LaskaKit/ESP32-H2-DEVKit/Version.md

### Version 2.0
- Redo all power part, now stable power
- Battery ADC pin changed from IO2 to IO3
- LED pin changed from IO9 to IO22
#### Version 1.1
- Initial | Počáteční
