LaskaKit/ESP32-H2-DEVKit/README_CZ.md

ESP32-H2 DevKit

# ESP32-H2 DEVkit

Vývojová deska s mikrokontrolerem ESP32-H2 speciálně navržená pro ultra nízkopříkonové IoT aplikace napájené z baterií. ESP32-H2-DEVKit je vývojová deska založená na ESP32-H2-MINI-1-N4, modulu pro všeobecné použití s 4MB SPI flash. Tato deska integruje kompletní funkce Bluetooth, ZigBee, Threada  Matter. Pozor! nemá Wi-Fi! Díky své volbě použitých komponent a obvodovému řešení se jedná o jednu z desek s extrémně malou spotřebou v režimu spánku. Také použitý typ mikrokontroleru - SoC ESP32 předurčuje tuto desku do vysoce výkonných IoT aplikací. Deska obsahuje i integrovanou nabíječku jednoho Li-ION článku, ze kterého je pak deska i napájena. S touto deskou již nemusíte volit mezi výkonem a spotřebou a tak se můžete plně soustředit na vlastní vývoj aplikace skoro bez omezení.

Rozteč I/O pinů byla záměrně zvolena tak, aby bylo možné celou desku ve fázi vývoje zasunout do nepájivého kontaktního pole, což může značně zjednodušit prvotní návrh vyvíjené aplikace.

Deska již obsahuje integrovaný programátor a tak již není nutné žádný jiný používat. Díky novému čipu programátoru a jeho zapojení není zásadně ovlivně spotřeba v režimu spánku a tudíž jej lze využívat i pro aplikace náročné na dlouhou dobu provozu při napájení z baterie.

Pro rychlý start s ESP32-H2 DevKit jsme připravili několik vzorových kódu https://github.com/LaskaKit/ESP32-H2-DEVKit/tree/main/SW

I2C (uŠup):</br>
SDA - IO11</br>
SCL - IO10</br>
Napájení - IO12</br>
</br>
Měření napětí baterie:</br>
IO2</br>
</br>
RGB LED:</br>
Data - IO9</br>
</br>
SPI (uŠup):</br>
CS - IO1</br>
SDI/MOSI - IO5</br>
MISO - IO0</br>
CLK - IO4</br>
</br>
## Vývojový kit ESP32-H2 DevKit můžeš zakoupit u nás na https://www.laskakit.cz/laskakit-esp32-h2-devkit-bluetooth--zigbee--thread--matter/
