LaskaKit/ESP32-H2-DEVKit/img/laskakit-esp32-h2-devkit-bluetooth--zigbee--thread--matter-3.jpg

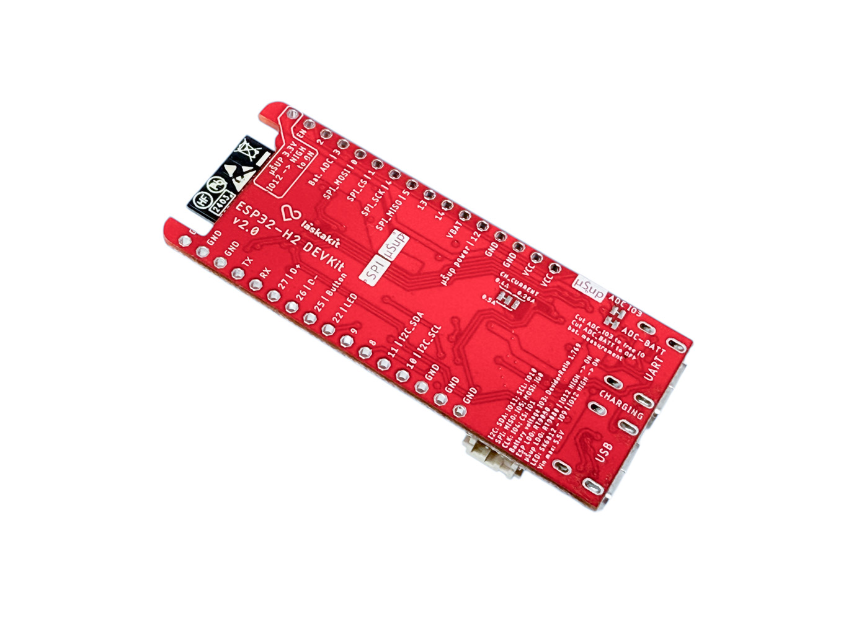
img/laskakit-esp32-h2-devkit-bluetooth--zigbee--thread--matter-3.jpg
