LaskaKit/ESP32-H2-DEVKit/HW/ESP32-H2-DEVKit_v2.pdf

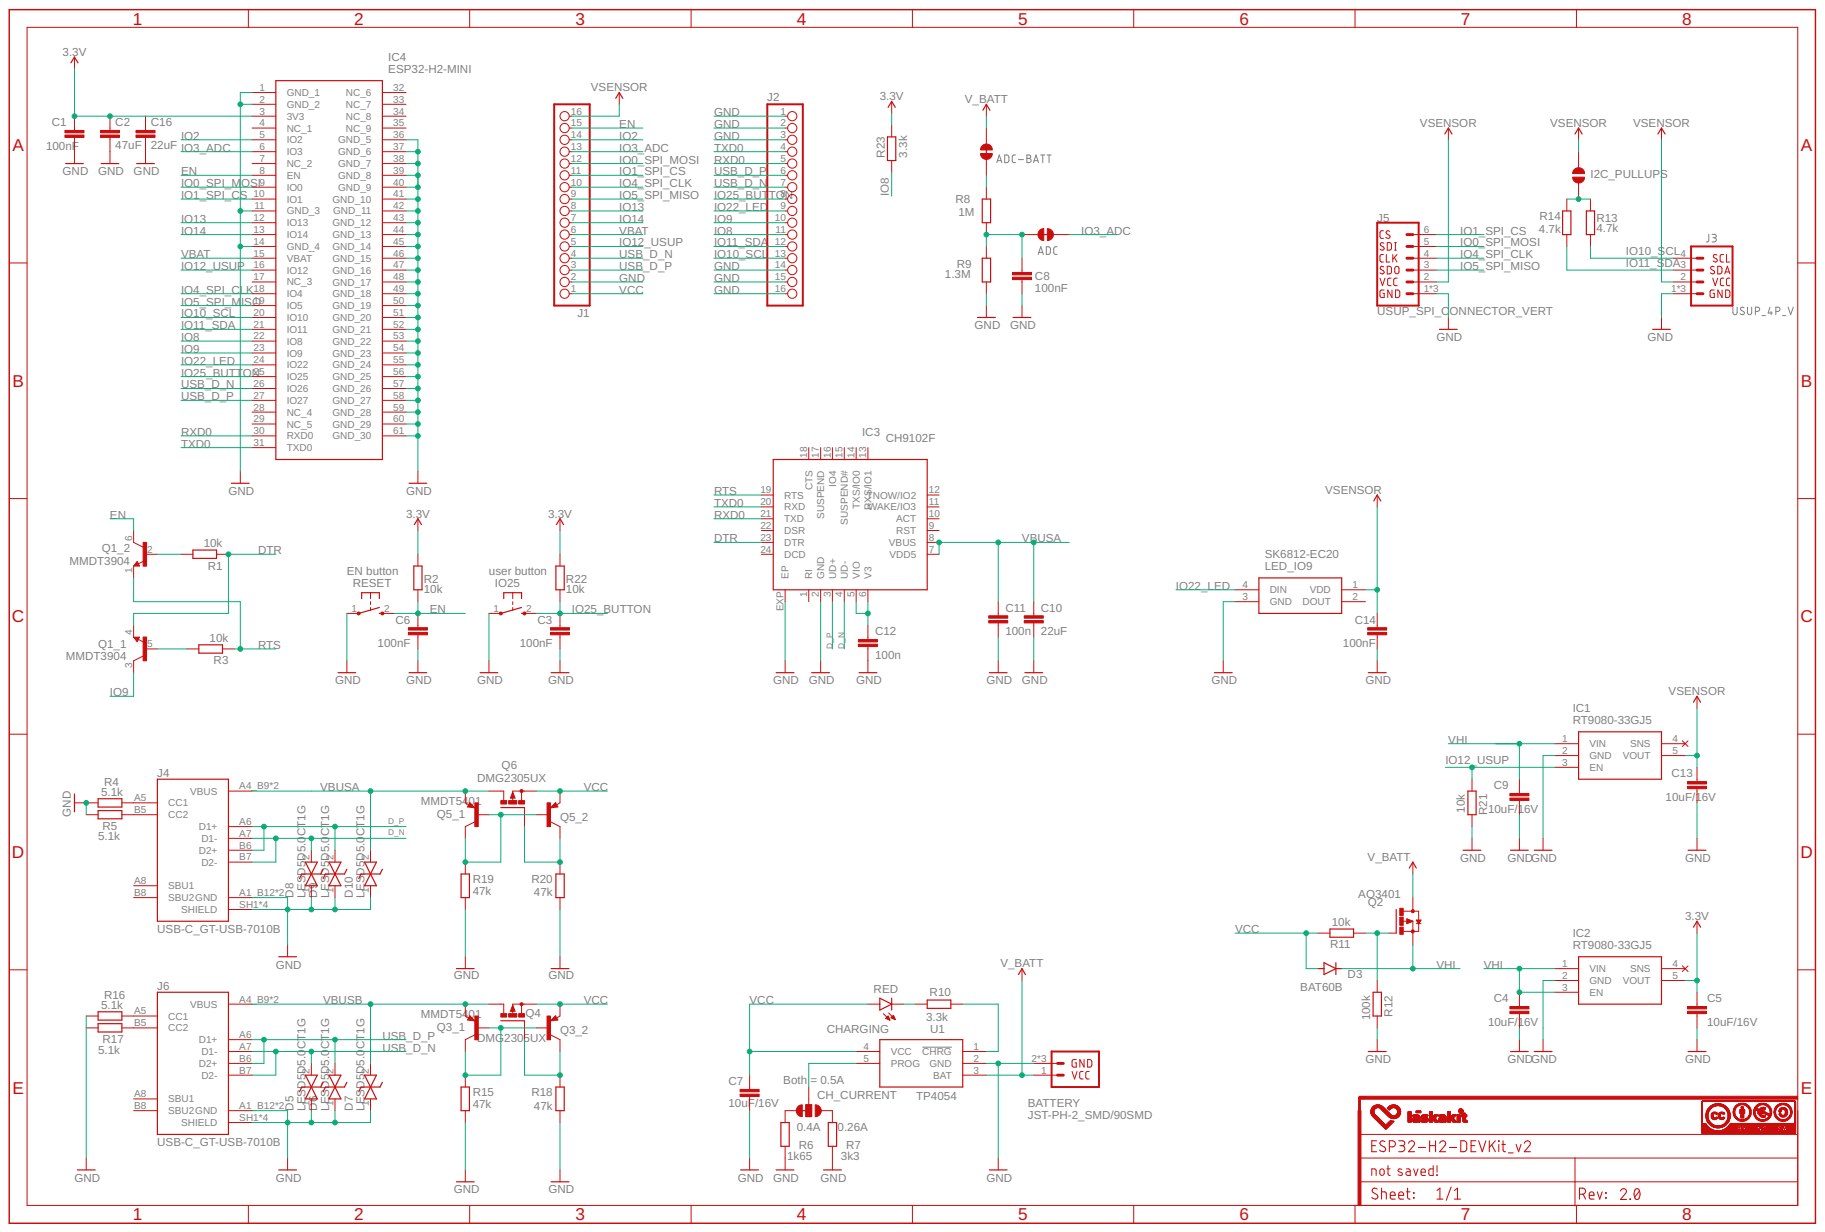
[picture p5: page 1]
