LaskaKit/ESP32-H2-DEVKit/HW/ESP32-H2-DEVKit_v1_1.pdf

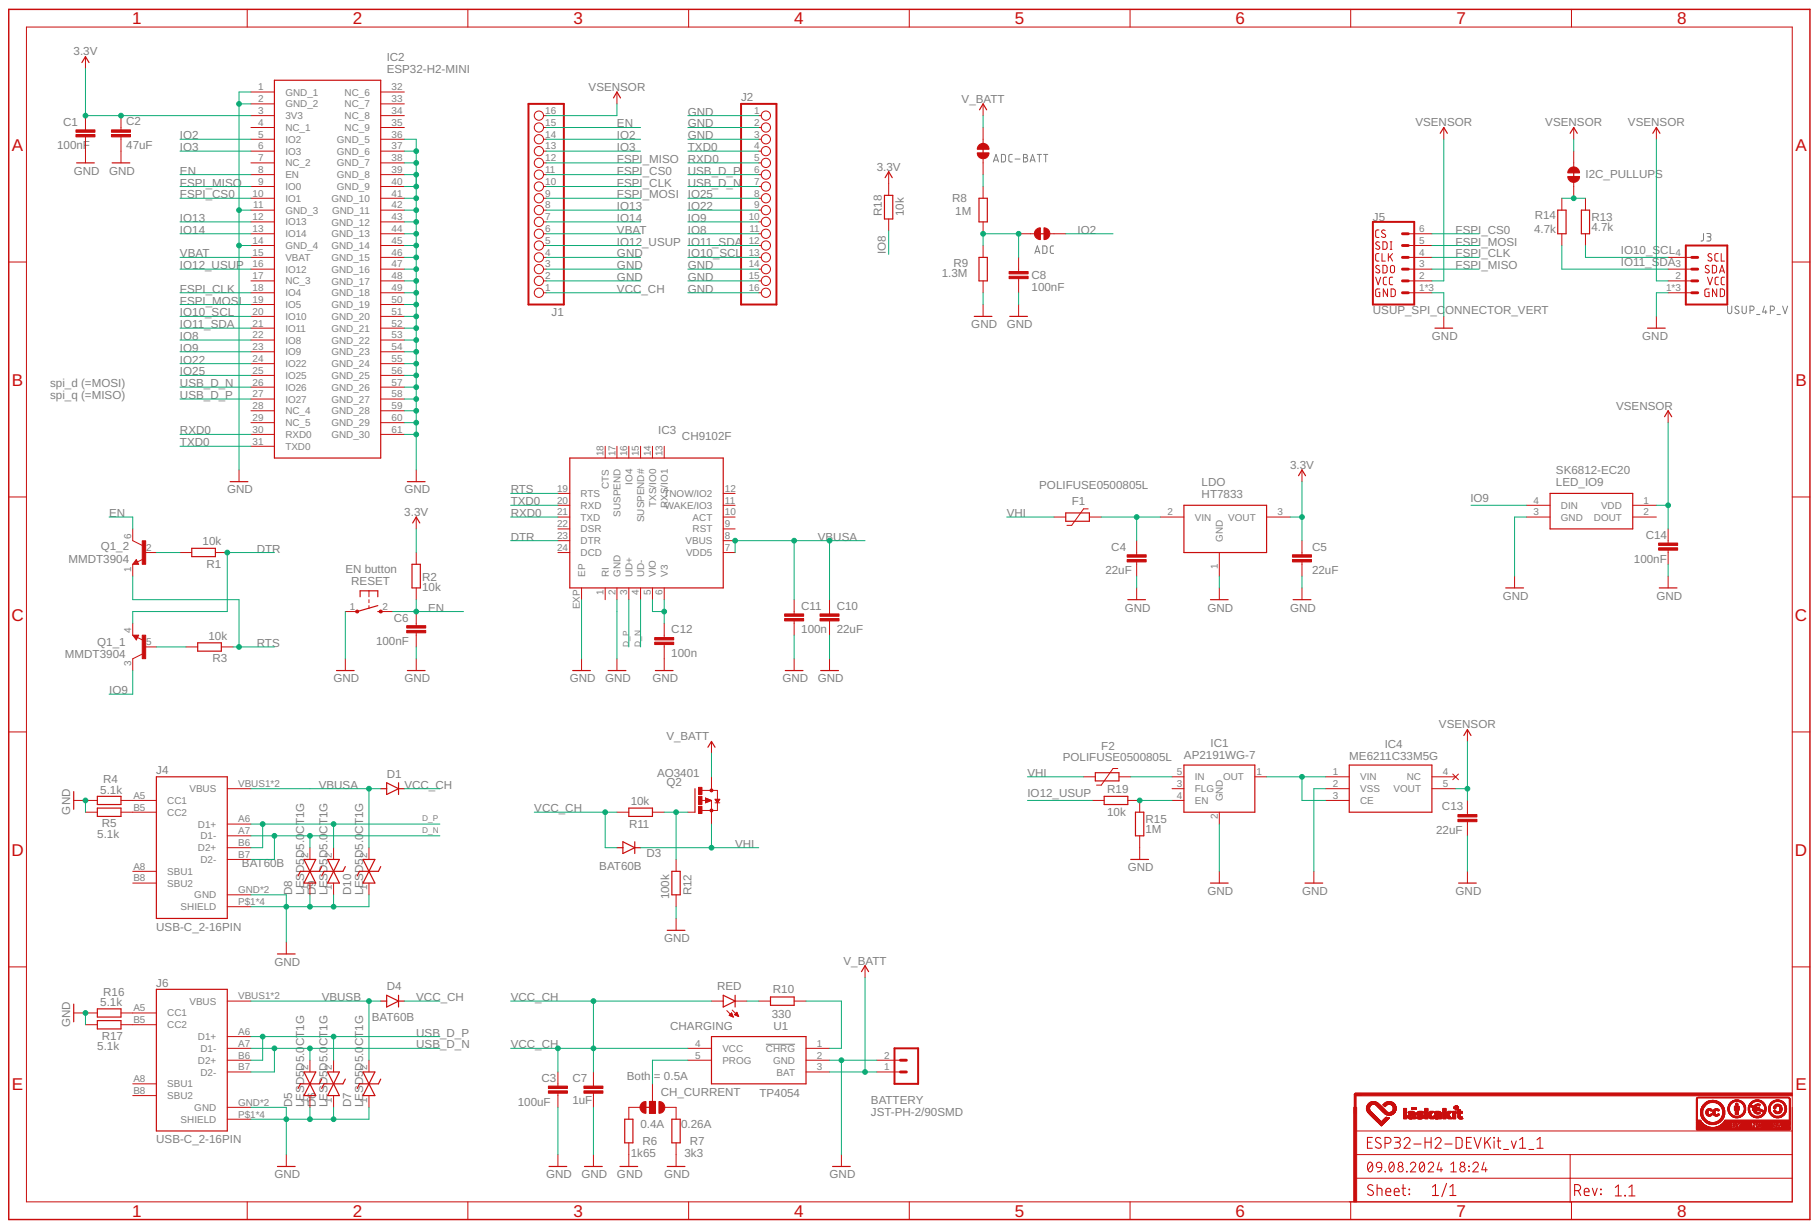
[picture p6: page 1]
