LaskaKit/ESP32-H2-DEVKit/HW/ESP32-H2-DEVKit_v1_0.pdf

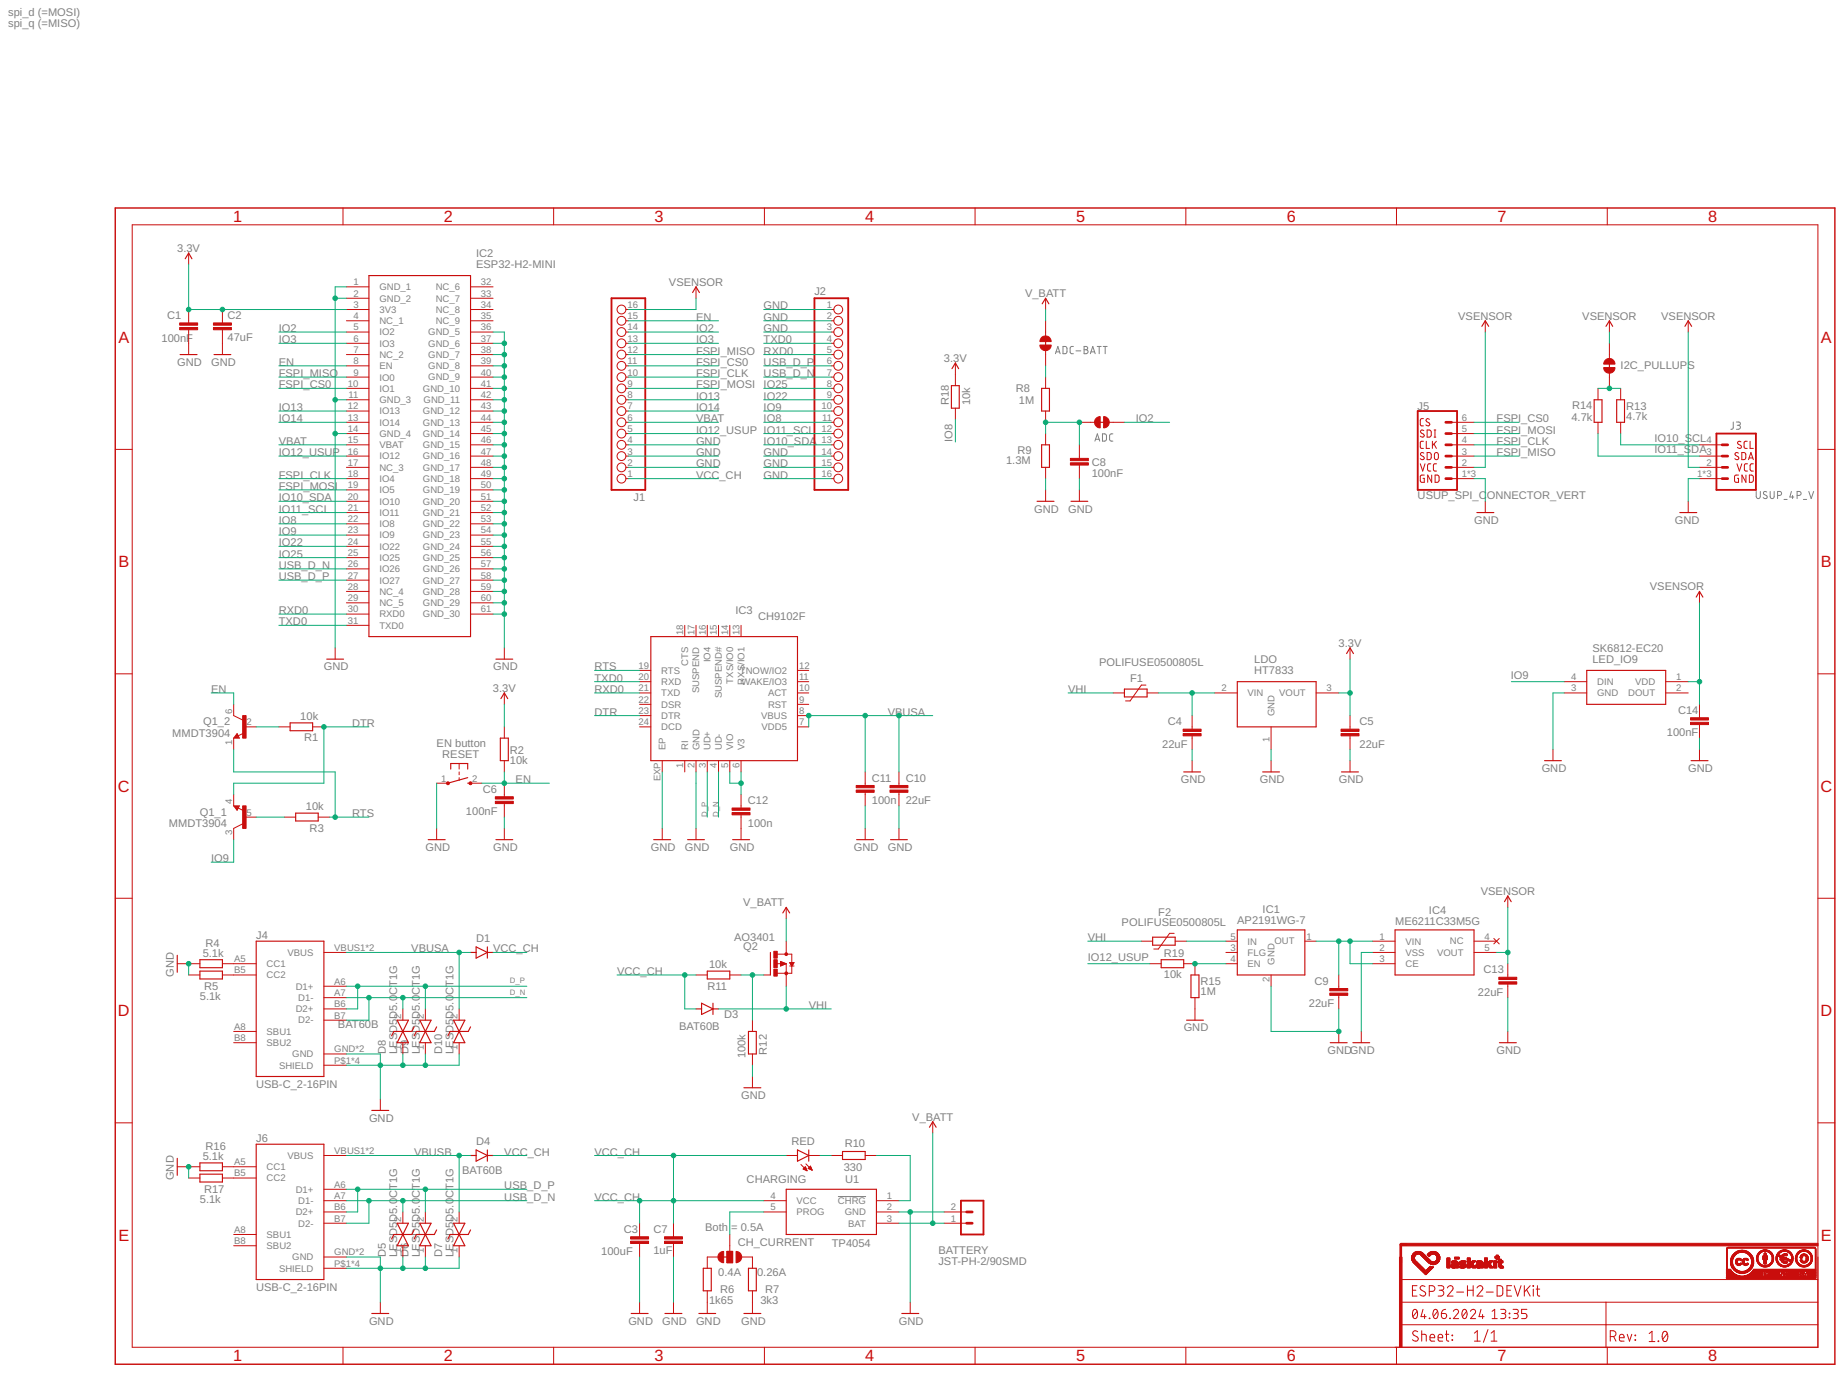
[picture p7: page 1]
